Ezhkin-Kot/cuttlefish/docs/images/03-45-rear-right.png

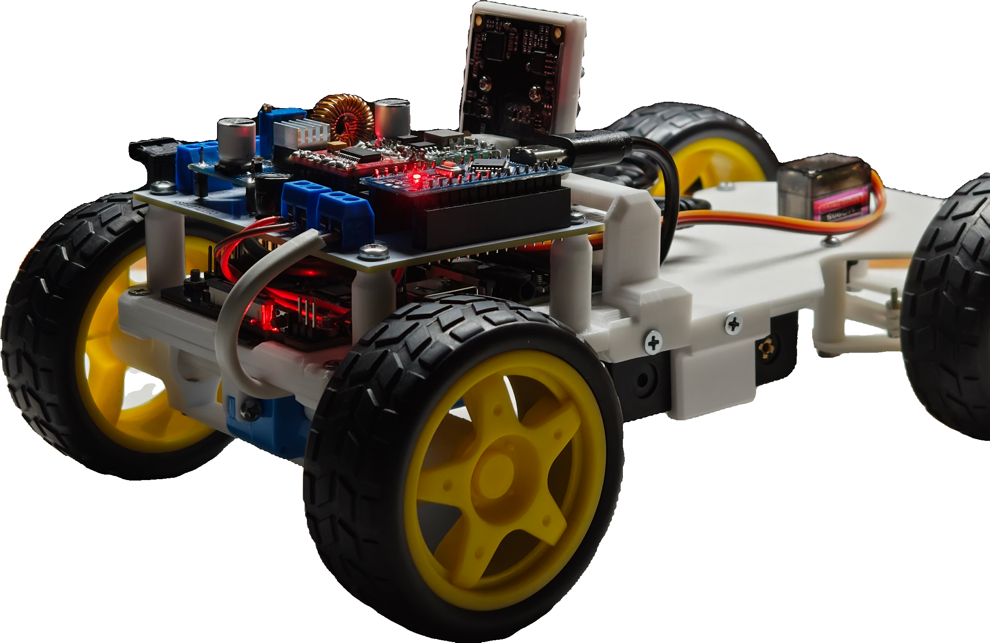
docs/images/03-45-rear-right.png
