Ezhkin-Kot/cuttlefish/docs/images/05-front.png

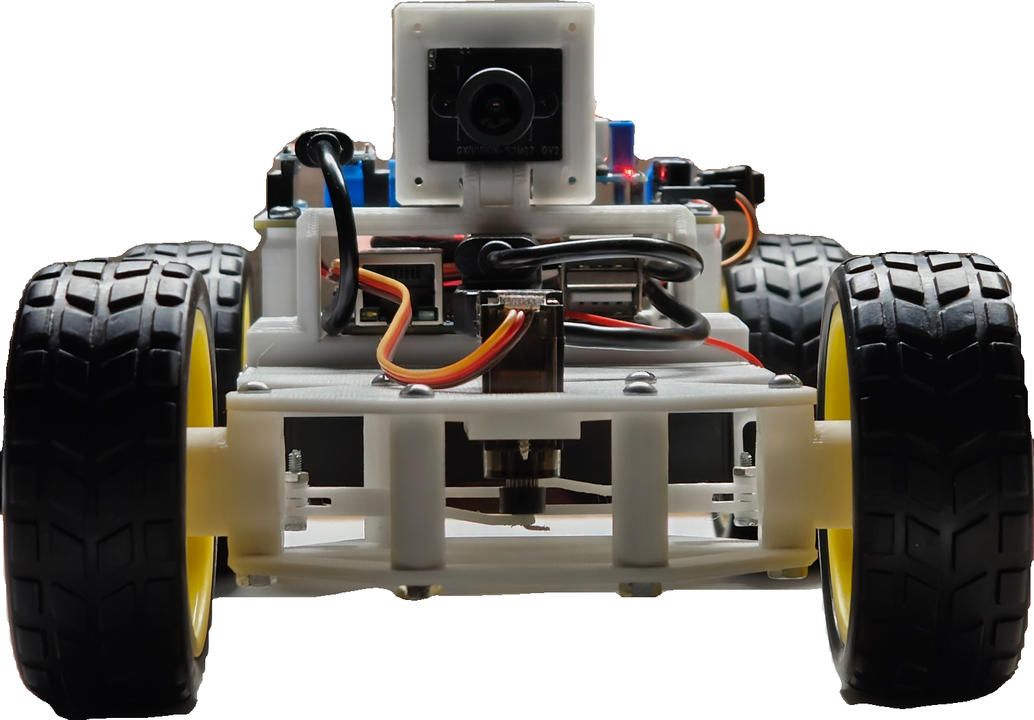
docs/images/05-front.png
