Ezhkin-Kot/cuttlefish/docs/images/06-left.png

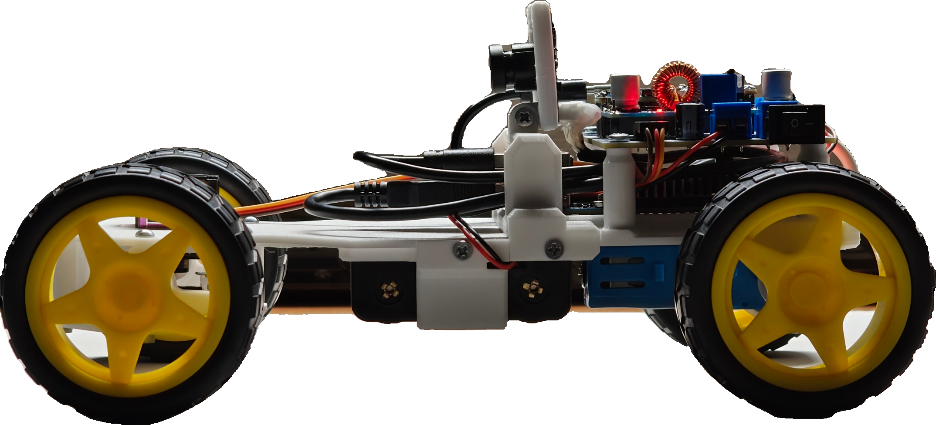
docs/images/06-left.png
