Ezhkin-Kot/cuttlefish/docs/images/07-right.png

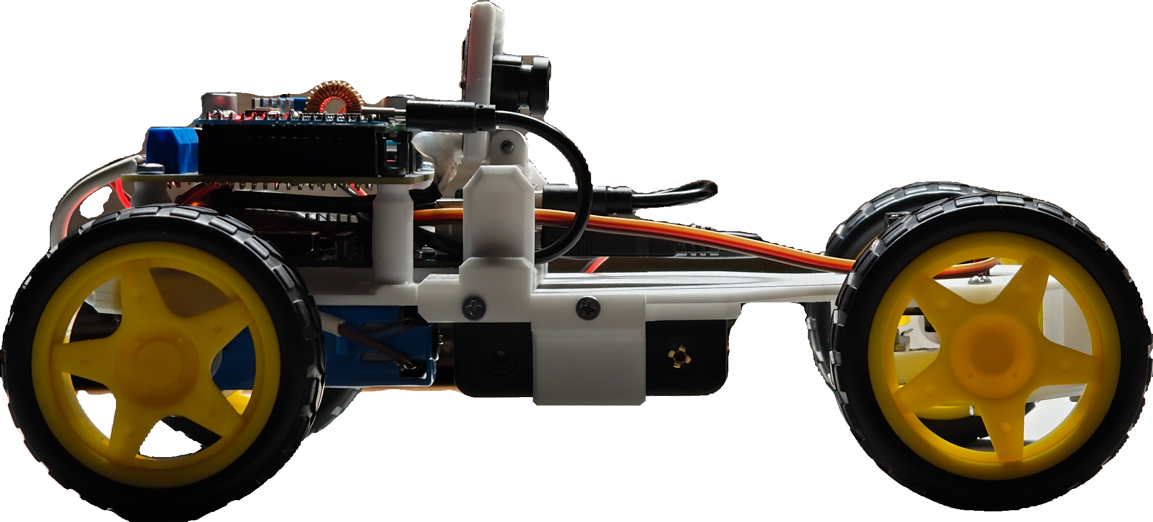
docs/images/07-right.png
