Ezhkin-Kot/cuttlefish/docs/images/08-rear.png

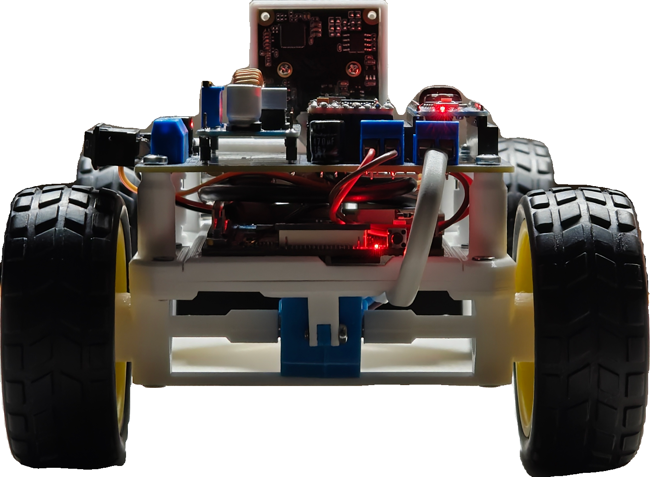
docs/images/08-rear.png
