Ezhkin-Kot/cuttlefish/docs/images/09-top.png

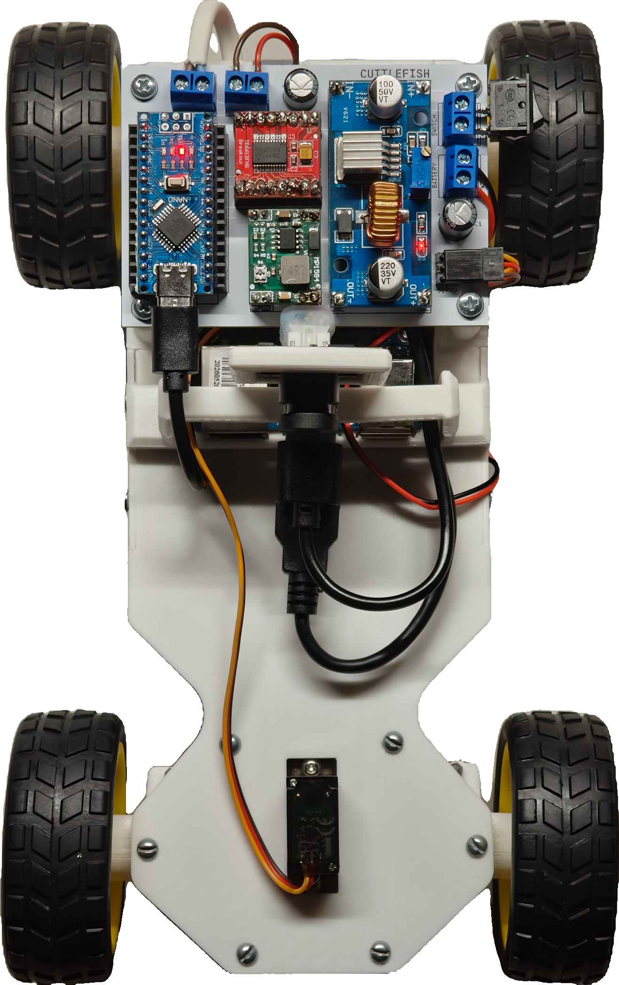
docs/images/09-top.png
