Ezhkin-Kot/cuttlefish/docs/images/10-bottom.png

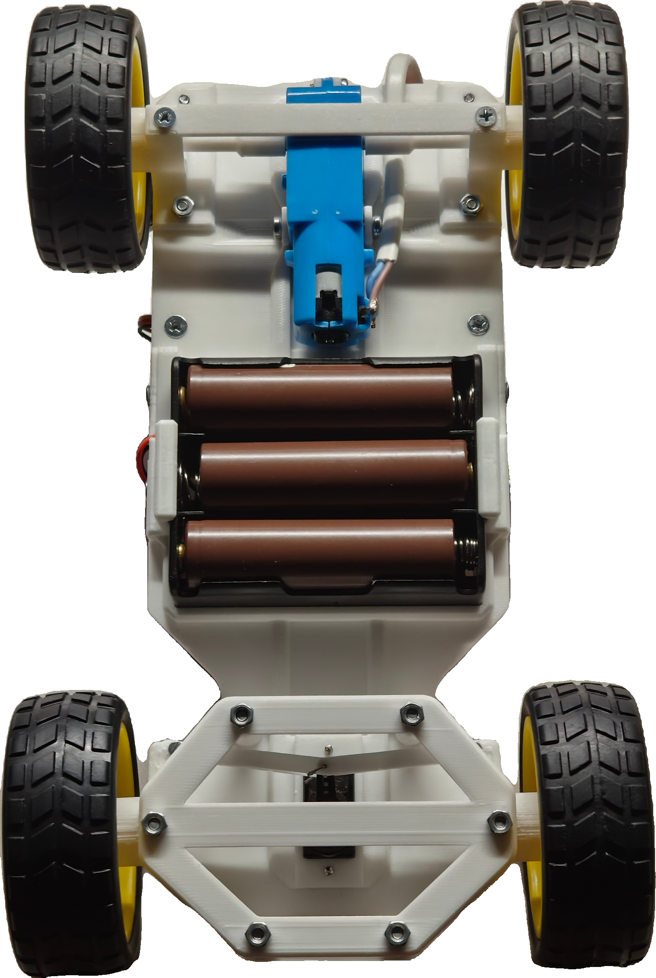
docs/images/10-bottom.png
