Ezhkin-Kot/cuttlefish/hardware/schemas/cuttlefish-carrier.csv

Reference | Value | DNP | Manufacturer | Manufacturer Part # | Qty
Arduino Nano1 | Arduino_Nano_v3.x Socket |  | Connfly | PBD-30 (DS-1023 - 2x15) | 2
BATTERY1 | Battery Socket |  | KLS | KLS2-301-5.00-02P-2S | 1
C1 | 470uF 16V |  | Rubycon | 16WXA470MEFC8X9 | 1
C2 | 470uF 16V |  | Rubycon | 16WXA470MEFC8X9 | 1
MOTOR1 | Motor Socket |  | KLS | KLS2-301-5.00-02P-2S | 1
MP1584 | DC-DC Converter Socket |  | Connfly | DS1002-03-1X2131 | 4
SBC1 | SBC Socket |  | KLS | KLS2-301-5.00-02P-2S | 1
SRV1 | Servo Socket |  | Connfly | PLS-40R 1x3 | 1
SWITCH1 | Switch Socket |  | KLS | KLS2-301-5.00-02P-2S | 1
TB6612FNG1 | Driver Socket |  | Connfly | PBS-8 (DS-1023 - 1x8) | 2
XL4015E1 | DC-DC Converter Socket |  | Connfly | DS1002-03-1X1-131 | 4
