Ezhkin-Kot/cuttlefish/hardware/schemas/cuttlefish-carrier.xlsx

Reference | Value | DNP | Manufacturer | Manufacturer Part # | Qty | P/N | Brand | Packing | Unit price | Total price
Arduino Nano1 | Arduino_Nano_v3.x Socket |  | Connfly | PBD-30 (DS-1023 - 2x15) | 2 | DS1023-2*15SF11 | Connfly | DIP | 36.400₽ | 728.000₽
BATTERY1 | Battery Socket |  | KLS | KLS2-301-5.00-02P-2S | 1 | DG301-5.0-02P-12-00A(H) | DEGSON | DIP | 18.200₽ | 182.000₽
C1 | 470uF 16V |  | Rubycon | 16WXA470MEFC8X9 | 1 | 16WXA470MEFC8X9 | Rubycon | DIP | 12.740₽ | 127.400₽
C2 | 470uF 16V |  | Rubycon | 16WXA470MEFC8X9 | 1 | 16WXA470MEFC8X9 | Rubycon | DIP | 12.740₽ | 127.400₽
MOTOR1 | Motor Socket |  | KLS | KLS2-301-5.00-02P-2S | 1 | DG301-5.0-02P-12-00A(H) | DEGSON | DIP | 18.200₽ | 182.000₽
MP1584 | DC-DC Converter Socket |  | Connfly | DS1002-03-1X2131 | 4 | DS1002-03-1X2131 | Connfly | DIP | 16.380₽ | 655.200₽
SBC1 | SBC Socket |  | KLS | KLS2-301-5.00-02P-2S | 1 | DG301-5.0-02P-12-00A(H) | DEGSON | DIP | 18.200₽ | 182.000₽
SRV1 | Servo Socket |  | Connfly | PLS-40R 1x3 | 1 | DS1022-1x3RUF11-B | Connfly | DIP | 4.550₽ | 45.500₽
SWITCH1 | Switch Socket |  | KLS | KLS2-301-5.00-02P-2S | 1 | DG301-5.0-02P-12-00A(H) | DEGSON | DIP | 18.200₽ | 182.000₽
TB6612FNG1 | Driver Socket |  | Connfly | PBS-8 (DS-1023 - 1x8) | 2 | DS1023-1x8SF11 | Connfly | DIP | 11.284₽ | 225.680₽
XL4015E1 | DC-DC Converter Socket |  | Connfly | DS1002-03-1X1-131 | 4 | X5511FV-01-C30D97-0970 | XKB | DIP | 9.100₽ | 364.000₽
 |  |  |  |  |  |  |  |  |  | 3001.180₽
