Ezhkin-Kot/cuttlefish/hardware/3d-models/cuttlefish.step

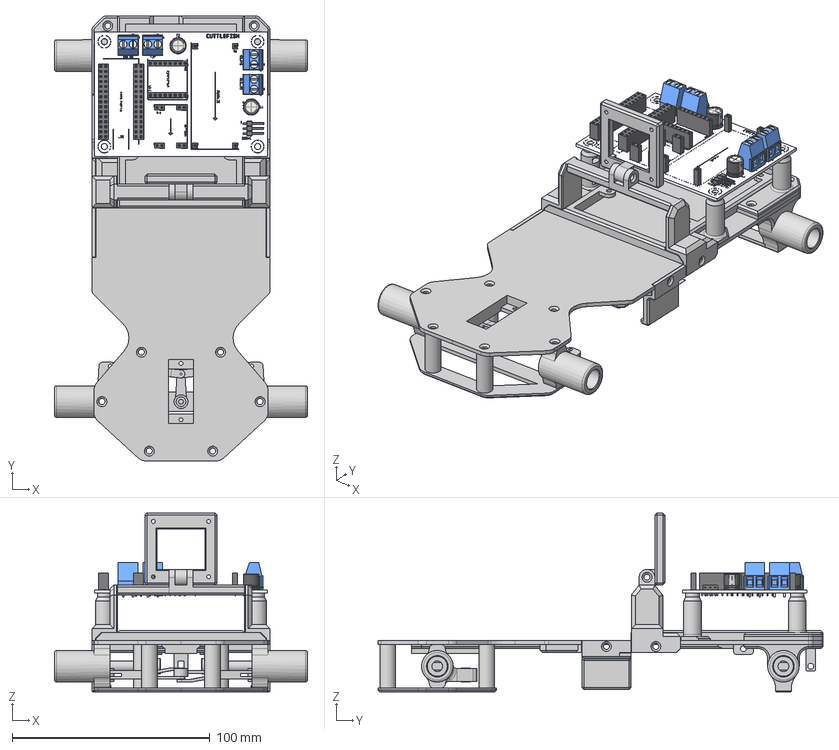
[picture p13: CAD file, 2026-10-30]
hardware/3d-models/cuttlefish.step
128.0 x 225.0 x 90.5 mm
TerminalBlock_Phoenix_MKDS-1,5-2_1x02_P5.00mm_Horizontal_1 x 4
PinSocket_1x08_P2.54mm_Vertical_1 x 2
PinSocket_1x02_P2.54mm_Vertical_1 x 4
PinSocket_2x15_P2.54mm_Vertical_1 x 2
PinHeader_1x03_P254mm_Horizontal
PinSocket_1x01_P2.54mm_Vertical_1 x 4
CP_Radial_D80mm_P350mm x 2
cuttlefish-carrier_silkscreen
cuttlefish-carrier_PCB
