Ezhkin-Kot/cuttlefish/hardware/schemas/cuttlefish-carrier.step

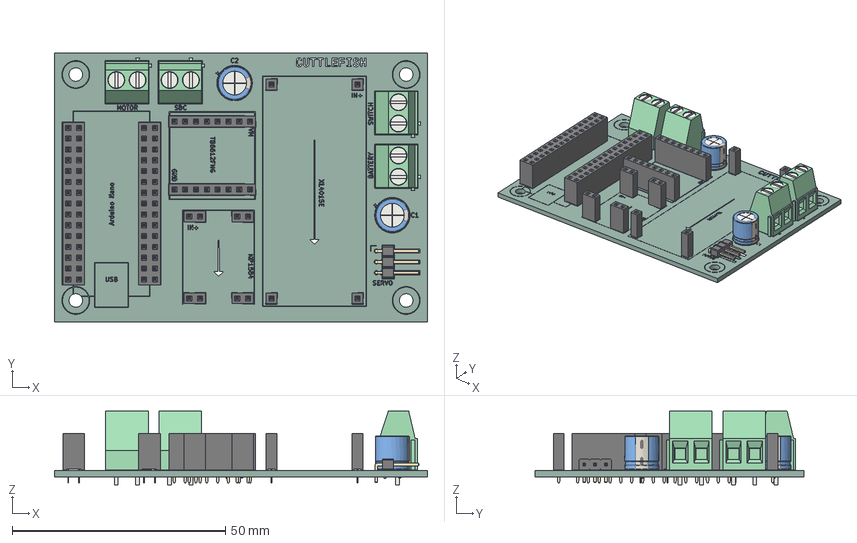
[picture p14: CAD file, 2026-10-30]
hardware/schemas/cuttlefish-carrier.step
87.5 x 63.0 x 17.3 mm
TerminalBlock_Phoenix_MKDS-1,5-2_1x02_P5.00mm_Horizontal x 4
PinSocket_1x08_P2.54mm_Vertical x 2
PinSocket_1x02_P2.54mm_Vertical x 4
PinSocket_2x15_P2.54mm_Vertical x 2
PinHeader_1x03_P254mm_Horizontal
PinSocket_1x01_P2.54mm_Vertical x 4
CP_Radial_D80mm_P350mm x 2
cuttlefish-carrier_silkscreen
cuttlefish-carrier_PCB
