Ezhkin-Kot/cuttlefish/(list of files, cad)

Other CAD files:
hardware/3d-models/cuttlefish.f3d
hardware/3d-models/cuttlefish.stl
