Ezhkin-Kot/cuttlefish/hardware/schemas/cuttlefish-carrier.kicad_pcb

## KiCad design hardware/schemas/cuttlefish-carrier.kicad_pcb (2026-10-30)

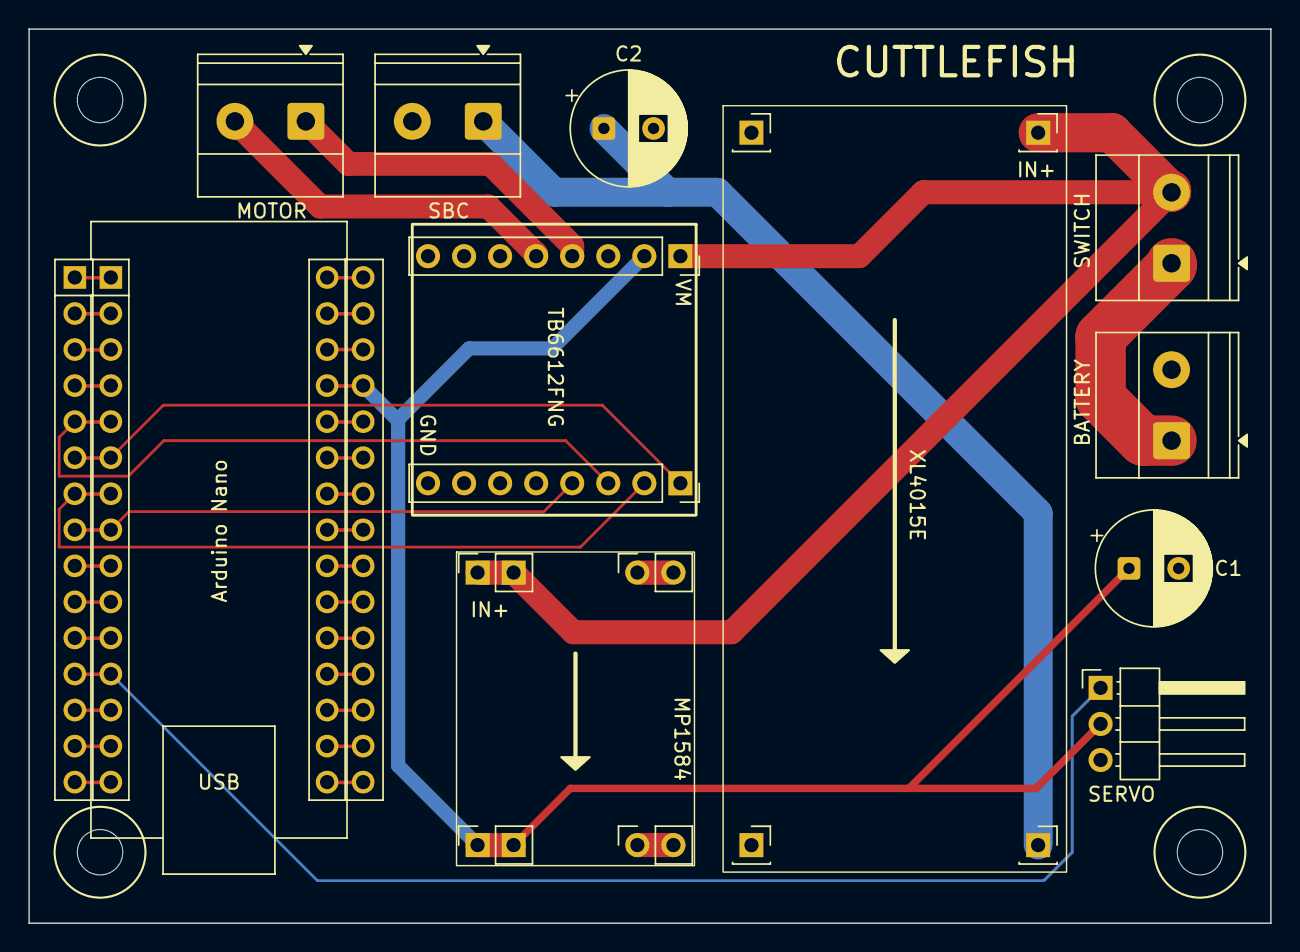
[picture p15: board cuttlefish-carrier.kicad_pcb from above]

Board: 2 copper layers, 87.5 x 63.0 mm, 11 parts (0 on the bottom side), 12 nets.

Parts:
Arduino Nano1: Arduino_Nano_v3.x; Arduino_Nano_Socket_2x15
BATTERY1: Battery_Socket; TerminalBlock_Phoenix_MKDS-1,5-2_1x02_P5.00mm_Horizontal
C1, C2: 470uF_16V; CP_Radial_D8.0mm_P3.50mm
MOTOR1: Motor_Socket; TerminalBlock_Phoenix_MKDS-1,5-2_1x02_P5.00mm_Horizontal
MP1584: MP1584_PinSocket
SBC1: SBC_Socket; TerminalBlock_Phoenix_MKDS-1,5-2_1x02_P5.00mm_Horizontal
SRV1: Servo_Socket; PinHeader_1x03_P2.54mm_Horizontal
SWITCH1: SW_SPST; TerminalBlock_Phoenix_MKDS-1,5-2_1x02_P5.00mm_Horizontal
TB6612FNG1: TB6612FNG_PinSocket
XL4015E1: XL4015E_PinSocket

Connections:
GND: Arduino Nano1.4 (GND), Arduino Nano1.29 (GND), BATTERY1.2, C1.2, C2.2, MP1584.2 (IN-), MP1584.4 (OUT-), SBC1.2, SRV1.3, TB6612FNG1.3 (GND), TB6612FNG1.8 (GND), TB6612FNG1.16 (GND), XL4015E1.2 (IN-), XL4015E1.4 (OUT-)
unnamed: Arduino Nano1.27 (+5V), C1.1, MP1584.3 (OUT+), SRV1.2, TB6612FNG1.2 (VCC)
unnamed: Arduino Nano1.5 (D2), TB6612FNG1.11 (AIN1)
unnamed: Arduino Nano1.6 (D3), TB6612FNG1.9 (PWMA)
unnamed: Arduino Nano1.7 (D4), TB6612FNG1.10 (AIN2)
unnamed: Arduino Nano1.8 (D5), TB6612FNG1.12 (STBY)
unnamed: Arduino Nano1.12 (D9), SRV1.1
unnamed: BATTERY1.1, SWITCH1.1 (A)
unnamed: MOTOR1.1, TB6612FNG1.4 (AO1)
unnamed: MOTOR1.2, TB6612FNG1.5 (AO2)
unnamed: MP1584.1 (IN+), SWITCH1.2 (B), TB6612FNG1.1 (VM), XL4015E1.1 (IN+)
unnamed: C2.1, SBC1.1, XL4015E1.3 (OUT+)
