Ezhkin-Kot/cuttlefish/(commit log)

2026-09-16 feat: change bluetooth to cable serial control
2026-09-16 feat: upload 3d models
    [robo-car.f3d, robo-car.stl]
2026-09-18 feat: add KiCad carrier board schema
    [cuttlefish-carrier.kicad_pcb, cuttlefish-carrier.kicad_sch]
2026-09-23 feat: update schemas
    [cuttlefish-carrier.kicad_pcb, cuttlefish-carrier.kicad_sch]
2026-09-23 feat: complete PCB
    [cuttlefish-carrier-B_Cu.gbr, cuttlefish-carrier-B_Mask.gbr, cuttlefish-carrier-B_Silkscreen.gbr, cuttlefish-carrier-Edge_Cuts.gbr, cuttlefish-carrier-F_Cu.gbr, cuttlefish-carrier-F_Mask.gbr, cuttlefish-carrier-F_Silkscreen.gbr, cuttlefish-carrier-NPTH.drl]
2026-09-24 feat: some changes
    [cuttlefish-carrier-B_Cu.gbr, cuttlefish-carrier-B_Mask.gbr, cuttlefish-carrier-B_Silkscreen.gbr, cuttlefish-carrier-Edge_Cuts.gbr, cuttlefish-carrier-F_Cu.gbr, cuttlefish-carrier-F_Mask.gbr, cuttlefish-carrier-F_Silkscreen.gbr, cuttlefish-carrier-NPTH.drl]
2026-10-15 feat: slop video streaming test
    [main.rs]
2026-10-26 3d: add board mounts and refactor model timeline
    [cuttlefish.f3d, cuttlefish.step, cuttlefish.stl, robo-car.f3d, robo-car.stl]
2026-10-28 3d: fix and redesign board mounts
    [cuttlefish.f3d, cuttlefish.step, cuttlefish.stl]
2026-10-29 3d: add battery holder and dovetail rail
    [cuttlefish.f3d, cuttlefish.step, cuttlefish.stl]
2026-10-30 3d: add camera holder and pcb step
    [cuttlefish.f3d, cuttlefish.step, cuttlefish.stl]
2026-10-30 pcb: fix hole positions and padding
    [cuttlefish-carrier.kicad_pcb, cuttlefish-carrier.step]
2026-11-01 feat: servo calibration
2026-11-01 3d: remove pcb step from stl
    [cuttlefish.stl]
2026-11-01 fix: right/left servo limit angle calibration
    [mcu-firmware.ino]
2026-11-01 docs/refactor: rewrite README, add licenses and separate project parts
    [cuttlefish-carrier-B_Cu.gbr, cuttlefish-carrier-B_Mask.gbr, cuttlefish-carrier-B_Silkscreen.gbr, cuttlefish-carrier-Edge_Cuts.gbr, cuttlefish-carrier-F_Cu.gbr, cuttlefish-carrier-F_Mask.gbr, cuttlefish-carrier-F_Silkscreen.gbr, cuttlefish-carrier-NPTH.drl]
2026-11-02 docs: add stl preview
